plreis/Sistemas-Embarcados/versoes/04_timer1_ctc/README.md

# 04 timer1 ctc

Etapa preservada do desenvolvimento. A comparação entre versões está no [índice](../README.md); o firmware de entrega está em [RelogioFinal](../../firmware/RelogioFinal).
