plreis/Sistemas-Embarcados/fotos/README.md

# Registro do protótipo

Fotografias do autor recebidas no pacote WhatsApp de 08/10/2026. Arquivos preservados sem alteração de conteúdo.

- [Aferição do relógio para apresentação](01_relogio_referencia.jpg)
- [Alarme habilitado](02_alarme_habilitado.jpg)
- [Edição de hora](03_edicao_hora.jpg)
- [Edição de segundos](04_edicao_segundos.jpg)
- [Edição de mês](05_edicao_mes.jpg)
- [Edição de dia](06_edicao_dia.jpg)
- [Edição de ano](07_edicao_ano.jpg)
- [Edição do alarme](08_edicao_alarme.jpg)
- [Edição da soneca](09_edicao_soneca.jpg)
