plreis/Sistemas-Embarcados/fotos/03_edicao_hora.jpg

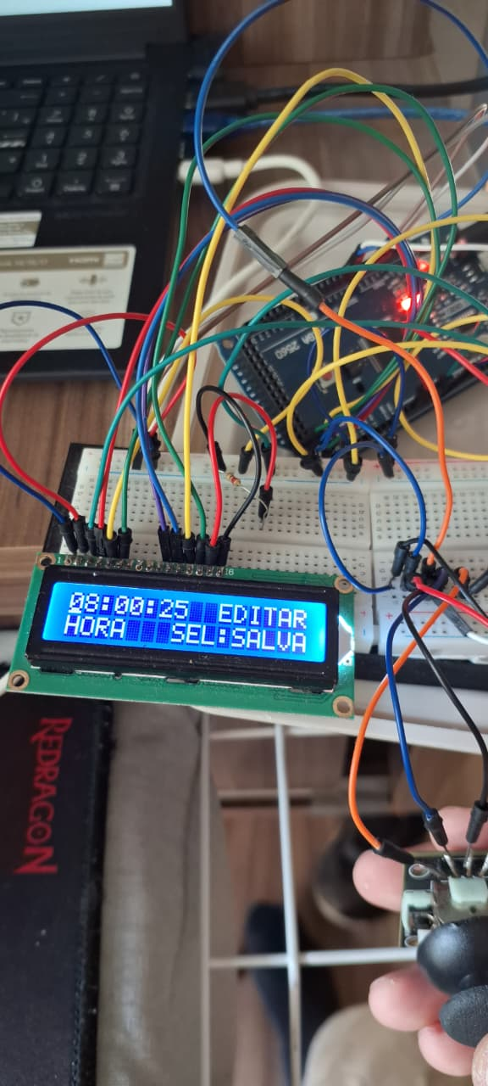
fotos/03_edicao_hora.jpg
