plreis/Sistemas-Embarcados/fotos/05_edicao_mes.jpg

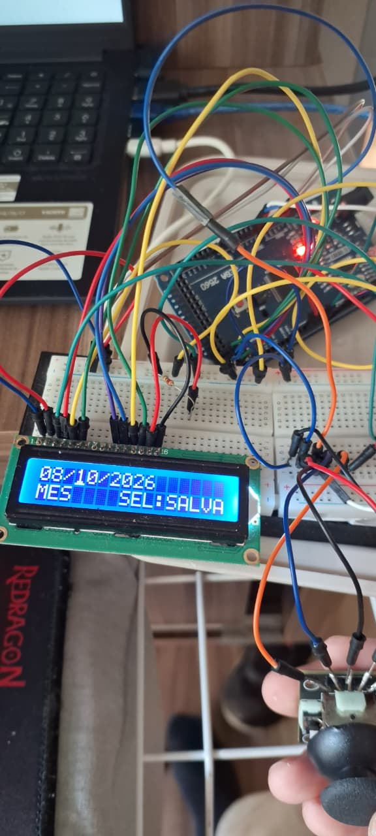
fotos/05_edicao_mes.jpg
