plreis/Sistemas-Embarcados/fotos/06_edicao_dia.jpg

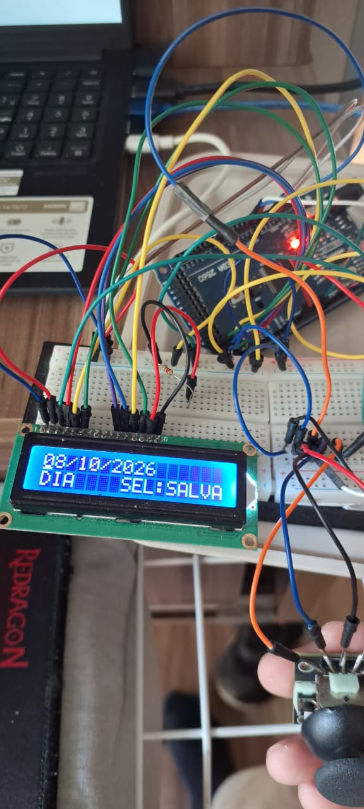
fotos/06_edicao_dia.jpg
