plreis/Sistemas-Embarcados/(commit log)

2026-10-08 Entrega final do relogio RTOS com relatorio, firmware e historico de versoes
2026-10-08 Adiciona slides para a banca com notas e roteiro de demonstracao
